formatBCE/Koala-Satellite/instructions/parts_and_tools.md

### Parts used
- microphones and DAC/AMP: Respeaker Lite board (bare board, without XIAO-S3 soldered on, like [this](https://www.seeedstudio.com/ReSpeaker-Lite-p-5928.html));
- main board: ESP32-S3 DevkitC N16R8 like [this](https://a.co/d/d8RYGGJ);
- rotary encoder: KY-040 ([i used this](https://a.co/d/8K1tguS));
- LED: 144 diodes/meter addressable WS2812B, 43 diodes long (exact strip i used isn't selling anymore, but any 144/m will fit);
- speaker: 2" 4Ohm 5W ([example](https://a.co/d/cEpEeNt));
- 10x M3 screws ([i used this set](https://a.co/d/e6pNfBu));
- 10x M3x4x5mm threaded inserts ([i used this](https://a.co/d/bMeMx9B));
- Jst 2.0 Ph 2-Pin Connector (male and female) for speaker like [this](https://a.co/d/aUkOTCS);
- some 3-wired male-female connector for easy LED strip connection ([i used one from this kit](https://a.co/d/9OdHJpC));
- cords of various length;
- 4x sticky rubber pads (to isolate enclosure vibrations from surface it's standing on).

### Tools used
- 3D printer for enclosure printing (better is better, i use Bambulab A1);
- prints cleanup tool;
- soldering iron and accessories;
- threaded inserts installation tool;
- screwdriver or allen wrench for screws.
