formatBCE/Koala-Satellite/(threads)

Thread 2 (2024-12-29):

[REQUEST] Add an ESP32-C6 as a "coprocessor" and radio module (making PCB have both a ESP32-S3 and a ESP32-C6) so that second SoC can be used as Thread Border Router

Hedda, 2024-12-29:
Please consider also adding an ESP32-C6 (or ESP32-H2) radio module as a "coprocessor" module as well to the same Voice Satellite solution, i.e. add a second radio SoC so the setup will have both a ESP32-S3 as well as a ESP32-C6/ESP32-H2 working on different things.

The main real-world use case reason to add an [ESP32-C6](https://www.espressif.com/en/products/socs/esp32-c6) (or an [ESP32-H2](https://www.espressif.com/en/products/socs/esp32-h2)) module other than just using it as a generic-coprocessor MCU SoC that could be used to offload stuff that ESP32-C6 (and ESP32-H2) has an IEEE 802.15.4 radio which means it can be used as a "Thread Border Router" (with OpenThread Border Router firmware), for a Thread network used by Matter standard fabric:

* https://www.home-assistant.io/integrations/matter/

  * https://www.home-assistant.io/integrations/thread/

While there is no real demand for Thread yet there will be in within a couple of years from now when Matter devices start to take off, so it would just be nice if the hardware was future-proofered for that reason when the added cost of another ESP32-C6 (or ESP32-H2) module now should be very little. At least then people would not need to update their hardware later.

* https://csa-iot.org/wp-content/uploads/2023/08/Matter-Retail-Education-Presenation.pdf

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

In the mean-time it might be a interesting to test proof-of-concept using the Espressif's ESP Thread Border Router / Zigbee GW:

* https://www.sparkfun.com/products/25497

* https://www.aliexpress.com/item/1005005688193617.html

Supposedly you can now get this working with Home Assistant's Thread integration (and Matter integration via that indirrectly):

* https://www.youtube.com/watch?v=nHH7j--lfDo

* https://github.com/home-assistant-libs/python-otbr-api/issues/61

Adding an extra ESP32 (ESP32-C6 or ESP32-H2) does take some space on PCB however should not add that much larger BOM cost,  but the additional possibilities such an extra ESP32 SoC could add should hopefully more than make up for that slightly higher cost!

You can possibly in the future alternativly also use ESP32-C6 (or ESP32-H2) on a single of them as a remote Zigbee Coordinator (also known as a Serial-over-IP Zigbee controller adapter) for [Home Assistant's built-in ZHA integration (native Zigbee Gateway)](https://www.home-assistant.io/integrations/zha), see/follow this work-in-progress but note that the ESP Zigbee radio for zigpy is is still very experimental and not yet fully working with ZHA:

* https://github.com/lhespress/zigpy-espzb
  * https://github.com/zigpy/zigpy-cli/pull/45
    * https://github.com/zigpy/zigpy/issues/1052

Another option would be to also use the ESP32-C6 as a "coprocessor" module a a dedicated Bluetooth Proxy chip with ESPHome:

* https://esphome.io/components/bluetooth_proxy.html

Note that the reason main you want to combine ESP32-S3 and ESP32-C6 is not only to off-load those processes but more importantly so you separate Wi-Fi signals from Thread/Zigbee signals, and that is due to WiFi tendacy to overwhelm and interfer with Thread/Zigbee communication because how they both work.

* https://www.home-assistant.io/integrations/zha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

Same goes by the way for WiFi and Bluetooth Low Entergy but it usually is not a great impact on user experience as for Thread/Zigbee:

* https://www.home-assistant.io/integrations/bluetooth#bluetooth-interference-with-other-devices

Anyway, what I think what would make a product like this (and others like the FutureProofHomes Satellite1) perfect as a "Thread Border Router" is that a user can add multiple Thread Border Routers (TBR/OTBR) to their Thread/Matter network for redundacy (using fail-over) and a voice assistant is something that many Home Assistant users are likely to have many of and placed all over their home, so having many Thread Border Routers is one of the keys to getting a more robust Thread network.

* https://www.home-assistant.io/integrations/thread/#about-thread-border-routers

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

As proof-of-concept of a ESP32-S3 + ESP32-H2 combination board made for this purpose check out see the "ESP Thread Border Router" board which is Espressif official SDK reference hardware for this purpose (can use used as either Thread Border Router or Zigbee Coordinator):

* https://openthread.io/guides/border-router/espressif-esp32

Development is primarily being done with Espressif's ESP Thread Border Router SDK hardware (based on ESP32-H2-MINI-1 module):

- https://docs.espressif.com/projects/esp-thread-br/en/latest/
  - https://github.com/espressif/esp-zigbee-sdk/tree/main/examples/esp_zigbee_gateway
    - https://github.com/espressif/esp-thread-br
    - https://github.com/espressif/esp-idf/tree/master/examples/openthread/ot_br
    - https://openthread.io/guides/border-router/espressif-esp32

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

OpenThread Border Router Example as in a similar two-SoC setup combining both a ESP32-S3 and ESP32-H2 in the same solution:

* https://github.com/espressif/esp-idf/tree/master/examples/openthread/ot_br

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

PS: I know Home Assistant Voice Preview Edition does not have this, but I believe that future revisions from them probably will 😜

* https://www.home-assistant.io/integrations/thread/#about-thread-border-routers

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

_Image taken from [the Thread Smart Home Fact Sheet](https://www.threadgroup.org/support#Resources) by the Thread Group. It illustrates the landscape of Matter, Thread, and Border routers. Instead of Matter, you could also see another protocol here, such as HomeKit._

_Unlike other IoT protocols, Thread can use multiple border routers in a single network. This increases wireless coverage and reduces the risk of a single point of failure. Ideal for home automation, with a potentially large number of devices spread over a large area._

Slightly different image here on the threadgroup.org when they describe a Thread based Matter fabric using the same text but also mentioning that _Thread Border Router can be built int many devices such as access points, **smart speakers**, etc._:

* https://www.threadgroup.org/BUILT-FOR-IOT/Smart-Home

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

PS: Also check out this blog which better describe what a Thread Border Router actually is and why it is very good to have many:

* https://www.threadgroup.org/news-events/blog/ID/356/WHAT-IS-A-THREAD-BORDER-ROUTER-AND-HOW-IS-IT-DIFFERENT-FROM-A-HUB-OR-BRIDGE

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

formatBCE, 2024-12-30:
I don't think this is my area. I'm just tinkerer, who added some peripherals to the PE code. The work you suggested is beyond my area of competence and the time that I can spend on it.

Also I think, such dramatic changes would fit separate product, Koala isn't the place for it...

Closed 2024-12-30.

Thread 3 (2025-01-02):

Question about KY-040 encoder: pushbutton SW not connected?

ooktown, 2025-01-02:
Greetings and thank you for the great projects using the ReSpeaker and Home Assistant Voice Assist! I already assembled the first version you released. Nice!

In regard to the Koala project, I noticed that the rotary encoder you specified (the KY-040 on Amazon) does not have the push button connected (in the picture of the part is shows "SW: No Pushbutton Switch"). In the YAML you have it connected to GPIO20. Wouldn't that just be a NOP since it's not connected to any physical input?

I'm planning to buy a rotary encoder with the push button connected to the SW output to either hook it to the MUTE on the ReSpeaker board, or use it as a button in Home Assistant to mute the audio if music is playing.

What are your thoughts on this? Am I reading the Amazon spec on the part incorrectly?

I'm looking forward to putting this project together!

formatBCE, 2025-01-02:
Those I have - have button connected. Nevertheless it works very flaky, so I don't use it anywhere. It can be used, but there's a lot of false-positives, as it's not very high quality I guess.

Feel free to omit it completely and delete from code, if you have rotary without button working...

Closed 2025-01-02.

Thread 4 (2025-01-03):

koala with respeaker with xiao esp32s3

rananna, 2025-01-03:
I have adapted koala yaml and aded a new faceplate for those that want to use the respeaker lite with integrated  xiao esp32 s3.
Please see the attached zip
[files.zip](https://github.com/user-attachments/files/18301137/files.zip)

formatBCE, 2025-01-03:
So no rotary?
What about LED strip?

rananna, 2025-01-03:
No rotary as not enough gpios, (hence new faceplate) and the led strip is supported as in koala.

rananna, 2025-01-03:
A solder connection is made to gpio 1 to the strip

formatBCE, 2025-01-03:
So it's working in parallel with inbuilt LED?
I see trouble there.... At least the code for inbuilt LED should be removed completely, and note added that LED on top will be flickering time to time... Don't really like this inconsistency.
The BOOT/RESET buttons and board USB won't be accessible too...

Also adding files via ZIP file isn't the way to add code changes to the repository.
You can create fork to this repo and add files there (probably, open PR after), but in current state it's unusable without shortcomings...

formatBCE, 2025-01-03:
You can use https://github.com/formatBCE/Respeaker-Lite-ESPHome-integration/tree/main for Respeaker Kit with XIAO.

rananna, 2025-01-03:
OK , I understand your position. I personally like the new case design for sound quality and wanted to make this accessible to those that have the respeaker with esp32.
I also find the top led is fine, it does not flicker but flashes when responding, and looks ok IMO.
The led ring looks great as it does in koala.
thanks again for offering koala as an open source gift to the community!

formatBCE, 2025-01-03:
Thank you for understanding! And i encourage you to make a fork and add the PR. It will gain more visibility and will be easier to use this way.

rananna, 2025-01-03:
Sorry, I don't understand your comment on the PR.
 I thought you didn't want to incorporate it? Making a PR for the other case design doesn't seem correct, it is a koala mod as it has a new faceplate and  uses the led ring.

formatBCE, 2025-01-03:
Exactly. It's modification, that will fit to someone's needs. In Github, the right way to make the modifications, is to:
- create fork to the repository
- add changes to that fork
- create PR from your repo to the main repo.

This way, even though i won't make it "official" by merging it into main repository - your code will be accessible for people that want to use it. Also it's easier to track changes this way. ZIP file can contain anything inside - but repository with YAML file is clear, visible and usable.

rananna, 2025-01-03:
ok understood.,  I will fork koala and make the pr.

Closed 2025-01-03.

Thread 7 (2025-01-19):

No really an issue just curious

soulripper13, 2025-01-19:
Will the system be able to power a a 10W speaker? I have a great speaker but I'm not sure if it will work.

formatBCE, 2025-01-19:
The Respeaker onboard amplifier is rated for 5W.
You can connect 10W speaker, if it has impendance 4 Ohm. It just will sound quieter.

Closed 2025-01-19.

Thread 9 (2025-01-21):

ESP-IDF compike error that git is not finding a repository at /

LocalNic, 2025-01-21:
Hi,
ESPHOME is creating problems in the newest / recommended ESP-IDF therefore I suggest to be more specific in the esp: section and define

esp32:
  framework:
    type: esp-idf
    version: 4.4.8
    platform_version: 5.4.0

instead of just

esp32:
  framework:
    type: esp-idf
    version: recommended

and update it when the compiler issues have been solved.

compiler issues are a bit missleading that there is no git found at /

formatBCE, 2025-01-21:
Thanks for reporting. Will apply today!

LocalNic, 2025-01-22:
I have a grown HASSOS and run ESPHOME since a few years.
With the update of ESP-IDF to 5.x.y it happens that some sources have problem compiling.

This is the error that you get.
`Reading CMake configuration...
-- Found Git: /usr/bin/git (found version "2.39.5")
-- git rev-parse returned 'fatal: not a git repository (or any parent up to mount point /)
Stopping at filesystem boundary (GIT_DISCOVERY_ACROSS_FILESYSTEM not set).'
-- The C compiler identification is GNU 12.2.0
-- The CXX compiler identification is GNU 12.2.0
-- The ASM compiler identification is GNU
-- Found assembler: /data/cache/platformio/packages/toolchain-xtensa-esp32s3/bin/xtensa-esp32s3-elf-gcc
-- Detecting C compiler ABI info
-- Detecting C compiler ABI info - done
-- Check for working C compiler: /data/cache/platformio/packages/toolchain-xtensa-esp32s3/bin/xtensa-esp32s3-elf-gcc - skipped
-- Detecting C compile features
-- Detecting C compile features - done
-- Detecting CXX compiler ABI info
-- Detecting CXX compiler ABI info - done
-- Check for working CXX compiler: /data/cache/platformio/packages/toolchain-xtensa-esp32s3/bin/xtensa-esp32s3-elf-g++ - skipped
-- Detecting CXX compile features
-- Detecting CXX compile features - done
-- Building ESP-IDF components for target esp32s3
NOTICE: Current idf-component-manager default lock file version is 2.0.0, but found 1.0.0 in /data/build/koala-satellite/dependencies.lock. Recreating lock file with the current version.
Manifest files have changed, solving dependencies.
....NOTICE: Updating lock file at /data/build/koala-satellite/dependencies.lock
Processing 2 dependencies:
[1/2] espressif/esp-nn (1.1.0)
[2/2] idf (5.1.5)
-- Configuring incomplete, errors occurred!
See also "/data/build/koala-satellite/.pioenvs/koala-satellite/CMakeFiles/CMakeOutput.log".

fatal: not a git repository (or any parent up to mount point /)
Stopping at filesystem boundary (GIT_DISCOVERY_ACROSS_FILESYSTEM not set).
CMake Error at /data/cache/platformio/packages/framework-espidf@src-6e6cd5244a43bdfe453daac50cfe73b6/tools/cmake/build.cmake:266 (message):
  Failed to resolve component 'freertos'.
Call Stack (most recent call first):
  /data/cache/platformio/packages/framework-espidf@src-6e6cd5244a43bdfe453daac50cfe73b6/tools/cmake/build.cmake:302 (__build_resolve_and_add_req)
  /data/cache/platformio/packages/framework-espidf@src-6e6cd5244a43bdfe453daac50cfe73b6/tools/cmake/build.cmake:303 (__build_expand_requirements)
  /data/cache/platformio/packages/framework-espidf@src-6e6cd5244a43bdfe453daac50cfe73b6/tools/cmake/build.cmake:303 (__build_expand_requirements)
  /data/cache/platformio/packages/framework-espidf@src-6e6cd5244a43bdfe453daac50cfe73b6/tools/cmake/build.cmake:603 (__build_expand_requirements)
  /data/cache/platformio/packages/framework-espidf@src-6e6cd5244a43bdfe453daac50cfe73b6/tools/cmake/project.cmake:604 (idf_build_process)
  CMakeLists.txt:3 (project)

========================= [FAILED] Took 18.06 seconds =========================`

If you use a strict definition of the Environment then it will compile.
This is actually a known Problem for all that uses ESP-IDF and not arduino as a framework.

I also know that it is not optimal because the ESP-IDF 5.x.y  holds alot of performance improvements.

BTW.: A reinstall of the ESPHOME plugin in HASS don't solve the problem, also cleaning the build won't help.
Maybe it is also just related to the Environment. but for now this is what solves the Problem and till now I cannot see any Problems with the code.

formatBCE, 2025-01-22:
Alright. I'll leave this open for information purposes. Won't change main YAML though - it must be local fix for those with such trouble.

formatBCE, 2025-05-17:
I put commented line with this into the YAML for tinkerers.

Closed 2025-05-17.

Thread 10 (2025-01-23):

Listen Light not working

LocalNic, 2025-01-23:
Hi,
your koala Satelite is a pretty cool extention, also integrate neat into HASS.

I have the Respeaker Lite with the ESP32S3 already soldered on the board.

When I import the "common/koala-base.yaml" I needed to addopt the Size of the ESP from
esp32:
  board: esp32-s3-devkitc-1
  variant: esp32s3
  flash_size: 16MB

to :
esp32:
  board: esp32-s3-devkitc-1
  variant: esp32s3
  flash_size: 8MB

otherwise the ESP will end in a Boot loop and you have to use a prettty small button next to the ESP32S3 to reflash the ESP32S3.

Also I havent seen the listen RGB working. Even your switch to activate a RGB Ring doesn't help.
Hope I address the Listen Light correctly to you and it is not a Problem with the "respeaker_lite_i2s_dfu_firmware_48k_v1.0.9.bin" firmware.

Really happy to report you about this points ;)
Good work !

formatBCE, 2025-01-23:
Hey!
Koala isn't supposed to work with inbuilt LED on Respeaker, nor with XIAO S3 on board. Check my other repo for YAML that works with Kit version: https://github.com/formatBCE/Respeaker-Lite-ESPHome-integration

Thread 13 (2025-03-19):

Alternative ESP32 boards

properlypurple, 2025-03-19:
I'm building one of these, but I've had trouble finding the ESP32 board locally. I'm looking to use another ESP32 board with the same specs. Can you share what does this part from the instructions does (I haven't been abler to find much information about this)?

> Bridge IN-OUT and RGB with solder on ESP board.

Thanks for designing and sharing this with us,

formatBCE, 2025-03-19:
Hi!

Oh, it's bummer that there's shortage of Devkit-C boards. But I'm sure you will find a way to put other S3 into the enclosure (or probably just make another enclosure?)...

Regarding bridged pads: Devkit-C has (by default unsoldered) pads:
- One is for onboard LED,vand it's completely unnecessary. I guess I can mention that in README. If your board doesn't have that, just remove the code part for ESP onboard light from config.
- Another is more important, and it makes 5V pin on board to work. By default, board doesn't provide 5V on the pin, but it's needed for Respeaker to work. So with your board just make sure you have voltage on 5V pin.

properlypurple, 2025-03-19:
Thank you for the explanation @formatBCE. I was able to find a board which has the same specs, and has a 5v output by default. I think I'll be able to make some modifications to the casing to use this board, and I'll share any modified models in a fork/PR.

Closed 2025-03-19.

Thread 16 (2025-04-01):

Smaller ESP board?

sixtyfive, 2025-04-01:
Hi, I wanted to ask what the reason for using such a big ESP32 devboard is. Wouldn't something smaller (and often cheaper) like the S3 SuperMini do just as good of a job? Lots of IO broken out: https://forum.fritzing.org/uploads/default/original/3X/8/0/80d21868184b4678d52fb7005db5317ee075ab77.jpeg (but probably I'm missing something...?)

formatBCE, 2025-04-01:
Well there's couple reasons, but none of them is mandatory.

1. Actually board length is ideal to be squeezed between top lid and USB port hole. With smaller board I'd have to re-thing placement.
2. I don't know if 5V line on such a tiny board can carry Respeaker and 5W speaker load. Devkit-C has pretty good 5V power line.
3. It's already tight there cable-wise, and I have enough experience with tiny boards to wish more comfort. :) Devkit-C is really convenient to work with.
4. The main reason of bigger case in Koala isn't the board, but the sound. So board size wasn't of concern. :)

You can do it for sure, and probably it will be cheaper - but I don't know if it will introduce any troubles - and it definitely will require enclosure change (although probably minor).

sixtyfive, 2025-04-02:
Understood, thanks for taking the time!

Closed 2025-04-01.

Thread 23 (2025-06-18):

Gpio13

levanLuongnt, 2025-06-18:
Which pin is gpio13 in the picture?

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

formatBCE, 2025-06-19:
There's no GPIO13 on Respeaker Lite board. This is pin on Esp32s3, which is connected to LED strip.

levanLuongnt, 2025-06-19:
Which pins to use for led strip with built in Xiaomi esp32s3

formatBCE, 2025-06-19:
There's no free pins on XIAO S3 in this configuration. You have to use inbuilt LED, or use that one named WS2812, but it's parallel to inbuilt RGB LED.

Closed 2025-06-19.

Thread 25 (2025-07-16):

Wiring diagram

rodrigosiviero, 2025-07-16:
Hi, Not really an issue but there's no other place to ask, I'm willing to build the Satellite but I'm not well versed in electronics, so I'm kinda trying to figure out how to wire all of these components, in the readme says to solder the JST female to the respeaker lite, but doesn't it come pre-soldered? Got a little bit confused.
Also regarding the led, knob and the respeaker lite going all to 5v, is it safe to put something like a wage terminal block to join all cables and solder it to the 5v or am I going to fry everything?

I did this wiring diagram from what I understood:

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

is  something like that?

Closed 2025-07-16.

Thread 26 (2025-08-22):

Fully assembled koala

ugomark, 2025-08-22:
Hi is there any chance to have it (in Italy) assembled and cased? Many thanks

formatBCE, 2025-08-22:
Hi!
At the moment, it would be MUCH cheaper and faster if you do it yourself... You're the first person to ask me about assembled device. I'm in Canada, so it would add at least half of the device price just for delivery. Not to mention that I don't have spare parts on me right now, so it would take time to order them from China. :)

ugomark, 2025-08-22:
Hi Andrii,
thank you for your answer.
It is over my competence, but I'll try to do something.
Please feel free to contact me if you will have further requests.
Congratulations for the project!
Ciao,  Ugo

Il Ven 22 Ago 2025, 15:41 Andrii Mitnovych ***@***.***> ha
scritto:

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
