formatBCE/Koala-Satellite/(commit log)

2025-07-16 Add wiring diagram by @rodrigo
2025-10-01 Release 2025.10.0 (#27)
    - [PE parity] added substitutions to voice files
    - [PE parity] added dynamic encryption to API
    - [PE parity] bumped ESPHome to 2025.9.3
    - fixed mic mute switch behaviour (switch.turn_on and switch.turn_off actions were toggling the switch)
2026-10-19 Clarify threaded inserts specifications
    Updated the description of threaded inserts to include dimensions.
2026-10-19 Bound the stop-word wait and fix stale next timer
    - activate_stop_word_once waits at most 5 s for the announcement (Voice PE #512)
    - on_timer_cancelled publishes -1 and "-" when no timer is left
2026-10-19 Pin the Respeaker Lite release instead of following main
    respeaker_lite_ref (2026.9.1) selects the respeaker_lite component, the
    kenobi model, and the XMOS firmware. i2s_audio_ref selects the fork.
2026-10-19 Build from the Respeaker Lite packages instead of a copy
    koala-base.yaml now gets the core and the ReSpeaker Lite hardware from
    Respeaker-Lite-ESPHome-integration at respeaker_lite_ref, and adds
    packages/koala/device.yaml with the Koala hardware only. Dashboard users
    copy only koala-dashboard.yaml, pinned with koala_ref. The release workflow
    reads the version from the device package and checks both koala_ref values.
2026-10-19 Release on version bump: build factory and OTA firmware in CI
    A push to main that changes esphome.project.version publishes it: the
    prepare job skips versions that have a tag, checks koala_ref and the Lite
    tag, and the build pins ESPHome and ewt-gen. ewt-gen now gets --import-url
    (koala-base.yaml at the release), --release-url, and --release-summary, and
    writes the manifest OTA entry itself. A manual run adds a summary.
    Release 2026.9.1: Respeaker Lite packages, pinned releases, stop-word wait,
    timer and LED fixes.
2026-10-19 Make the board pins configurable and add an opt-in dial mute (#46)
    Board pins are substitutions with DevKitC defaults, so another ESP32-S3
    board needs no fork. dial_button_mutes_speaker (default false) lets the
    dial press toggle the speaker mute; it stays off on the DevKitC, where
    GPIO20 is a noisy USB pin. The assembly guide now connects the KY-040 to
    3V3, because its pull-ups otherwise put 5 V on the GPIOs.
2026-10-20 Release 2026.9.2 with Respeaker Lite 2026.9.4 (#47)
    Lite 2026.9.4 ships the built-in sounds as Opus, -362 KB flash. This
    release also publishes the configurable board pins and the opt-in dial
    mute (#46).
2026-10-20 Release 2026.10.0 with Respeaker Lite 2026.10.0 (#48)
    Release 2026.10.0 with Respeaker Lite 2026.10.0
    Respeaker Lite 2026.10.0 adds "Snooze" for a ringing timer or alarm
    (model by @dlarkinsPonderosa). Koala's alarm_on triggers replace the
    core's, so the core watches alarm_on in its snooze check instead.
2026-10-21 Add the reported XIAO ESP32-S3 LED ring pin (#49)
    The LED ring stays on GPIO13: a small pad on the XIAO ESP32-S3 Plus, the
    camera board pads on the standard XIAO ESP32-S3 (reported in #46, not
    tested). The report has no pin for the Koala button.
2026-10-21 Release 2026.10.1 with Respeaker Lite 2026.10.1 (#50)
    - Respeaker Lite 2026.10.1 brings the boot LED crash fix of the
    respeaker_lite component.
    - The ReSpeaker onboard LED (GPIO1) uses explicit timings with a 300 us
    reset and max_refresh_rate 15ms instead of the ws2812 preset, which
    sends no reset. The same LED stayed lit on the Respeaker Lite when a
    frame followed the previous one too closely
    (Respeaker-Lite-ESPHome-integration#88).
2026-10-21 Release 2026.10.2 with Respeaker Lite 2026.10.2 (#51)
    Release 2026.10.2 with Respeaker Lite 2026.10.2
    Respeaker Lite 2026.10.2 uses the stock ESPHome resampler microphone
    instead of the i2s_audio fork, so the firmware needs ESPHome 2026.10.0.
    The release workflow builds with 2026.10.0, and the factory config uses
    improv_ble, the new name of esp32_improv.
